jasensiopalao/thermal_camera/schematics/thermal_camera_version_1_0.gif

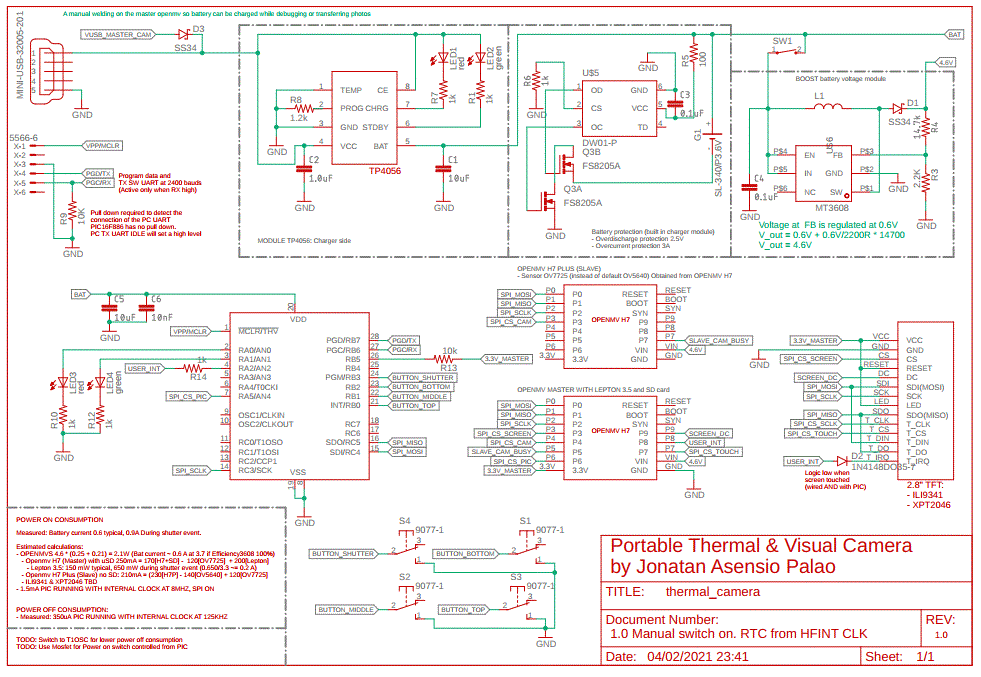
schematics/thermal_camera_version_1_0.gif
