jasensiopalao/thermal_camera/src/openmv_thermal/startup.bmp

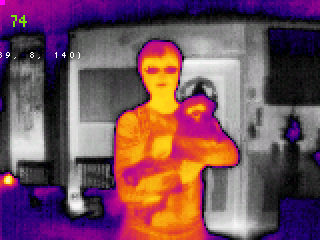
src/openmv_thermal/startup.bmp
