jasensiopalao/thermal_camera/schematics/thermal_camera_1_1.pdf

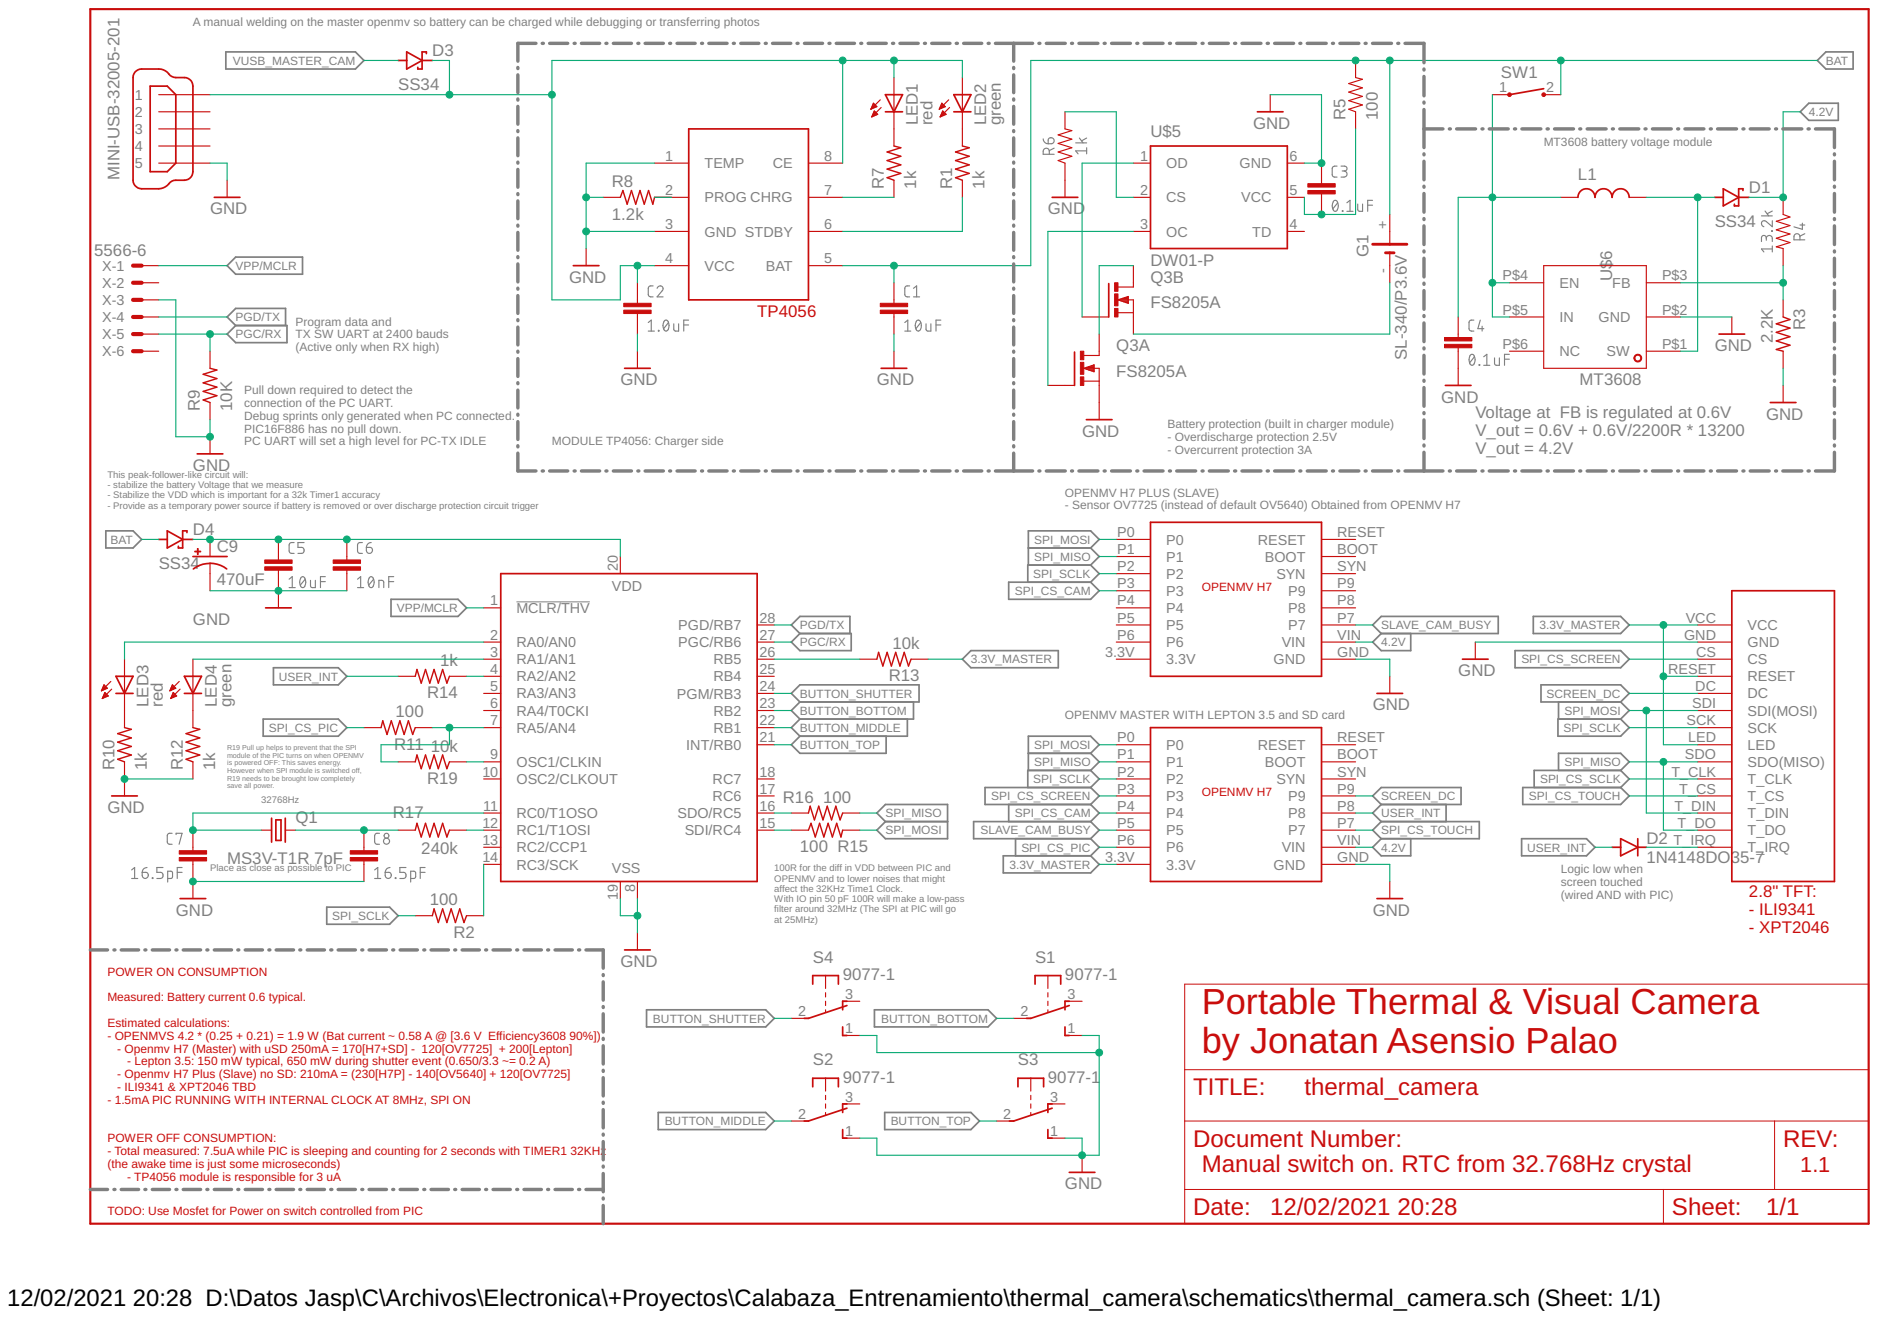
[picture p23: page 1]

A manual welding on the master openmv so battery can be charged while debugging or transferring photos

P$1 GND

Program data and TX SW UART at 2400 bauds

(Active only when RX high)

Pull down required to detect the
connection of the PC UART. Debug sprints only generated when PC connected. PIC16F886 has no pull down. PC UART will set a high level for PC-TX IDLE

This peak-follower-like circuit will: - stabilize the battery Voltage that we measure

OPENMV H7 PLUS (SLAVE)
- Sensor OV7725 (instead of default OV5640) Obtained from OPENMV H7

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

OPENMV MASTER WITH LEPTON 3.5 and SD card

R19 Pull up helps to prevent that the SPI module of the PIC turns on when OPENMV

is powered OFF: This saves energy. However when SPI module is switched off, R19 needs to be brought low completely

Place as close as possible to PIC

(wired AND with PIC) 100R for the diff in VDD between PIC and OPENMV and to lower noises that might affect the 32KHz Time1 Clock. With IO pin 50 pF 100R will make a low-pass

filter around 32MHz (The SPI at PIC will go
at 25MHz)

POWER ON CONSUMPTION Measured: Battery current 0.6 typical. Estimated calculations: - OPENMVS 4.2 * (0.25 + 0.21) = 1.9 W (Bat current ~ 0.58 A @ [3.6 V Efficiency3608 90%])

Portable Thermal & Visual Camera
by Jonatan Asensio Palao

- Openmv H7 (Master) with uSD 250mA = 170[H7+SD] - 120[OV7725] + 200[Lepton] - Lepton 3.5: 150 mW typical, 650 mW during shutter event (0.650/3.3 ~= 0.2 A)

- Openmv H7 Plus (Slave) no SD: 210mA = (230[H7P] - 140[OV5640] + 120[OV7725] - ILI9341 & XPT2046 TBD

- 1.5mA PIC RUNNING WITH INTERNAL CLOCK AT 8MHz, SPI ON

POWER OFF CONSUMPTION: - Total measured: 7.5uA while PIC is sleeping and counting for 2 seconds with TIMER1 32KHz

Document Number: Manual switch on. RTC from 32.768Hz crystal | REV: 1.1

(the awake time is just some microseconds)
- TP4056 module is responsible for 3 uA

TODO: Use Mosfet for Power on switch controlled from PIC

Date: 12/02/2021 20:28 | Sheet: 1/1

12/02/2021 20:28 D:\Datos Jasp\C\Archivos\Electronica\+Proyectos\Calabaza_Entrenamiento\thermal_camera\schematics\thermal_camera.sch (Sheet: 1/1)
