jasensiopalao/thermal_camera/schematics/thermal_camera_version_1_0.pdf

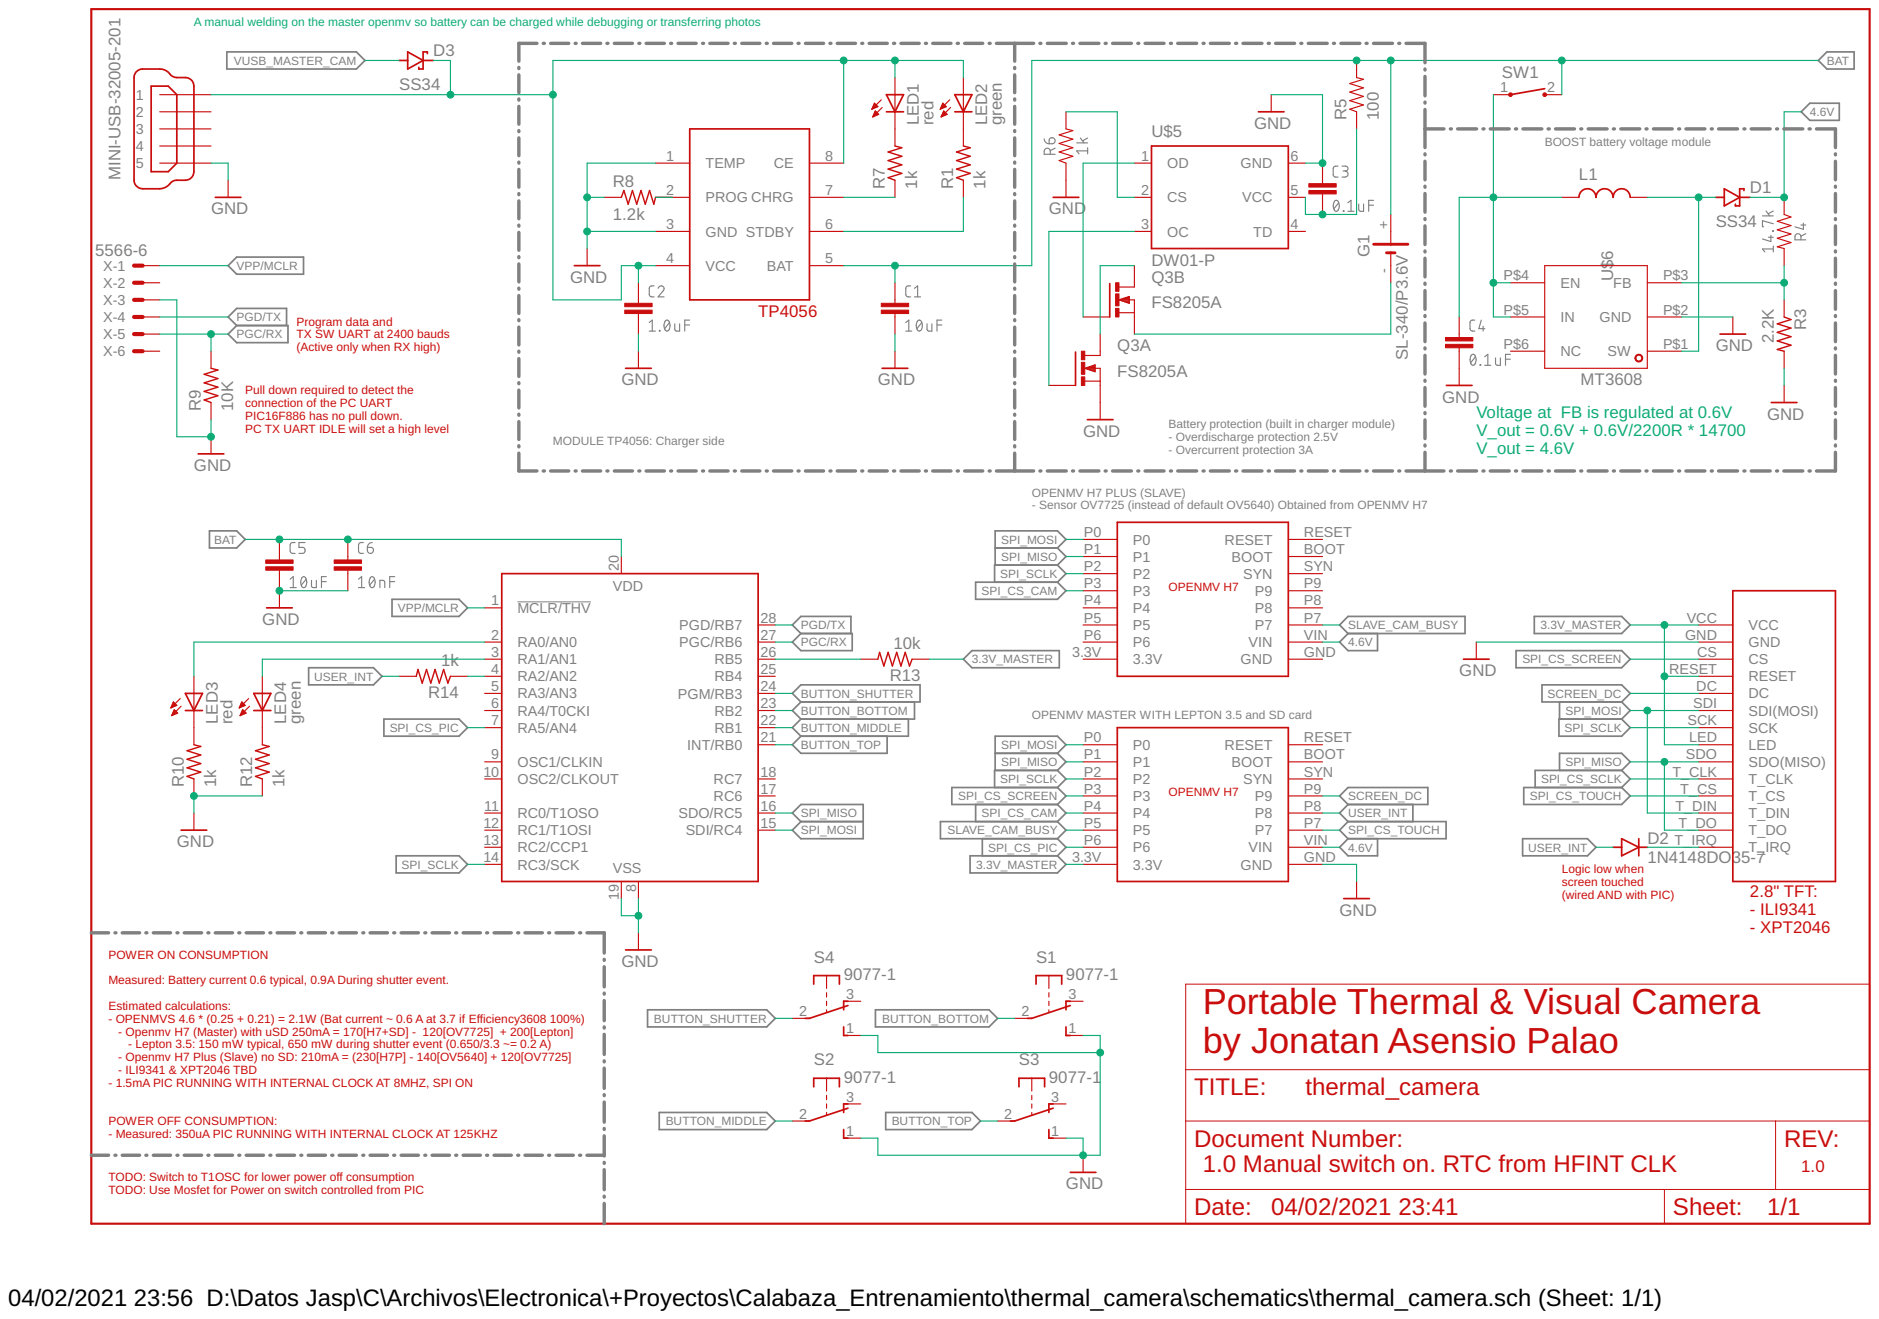
[picture p24: page 1]
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

BOOST battery voltage module

P$1 GND

Program data and TX SW UART at 2400 bauds

(Active only when RX high)

Pull down required to detect the
connection of the PC UART PIC16F886 has no pull down. PC TX UART IDLE will set a high level

OPENMV H7 PLUS (SLAVE)
- Sensor OV7725 (instead of default OV5640) Obtained from OPENMV H7

OPENMV MASTER WITH LEPTON 3.5 and SD card

Logic low when
screen touched
(wired AND with PIC)

POWER ON CONSUMPTION Measured: Battery current 0.6 typical, 0.9A During shutter event. Estimated calculations: - OPENMVS 4.6 * (0.25 + 0.21) = 2.1W (Bat current ~ 0.6 A at 3.7 if Efficiency3608 100%)

Portable Thermal & Visual Camera
by Jonatan Asensio Palao

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

- Openmv H7 Plus (Slave) no SD: 210mA = (230[H7P] - 140[OV5640] + 120[OV7725] - ILI9341 & XPT2046 TBD

- 1.5mA PIC RUNNING WITH INTERNAL CLOCK AT 8MHZ, SPI ON

POWER OFF CONSUMPTION: - Measured: 350uA PIC RUNNING WITH INTERNAL CLOCK AT 125KHZ

Document Number: 1.0 Manual switch on. RTC from HFINT CLK | REV: 1.0

TODO: Switch to T1OSC for lower power off consumption TODO: Use Mosfet for Power on switch controlled from PIC

Date: 04/02/2021 23:41 | Sheet: 1/1

04/02/2021 23:56 D:\Datos Jasp\C\Archivos\Electronica\+Proyectos\Calabaza_Entrenamiento\thermal_camera\schematics\thermal_camera.sch (Sheet: 1/1)
