jasensiopalao/thermal_camera/schematics/thermal_camera.sch

## EAGLE design schematics/thermal_camera.sch (2021-02-14)

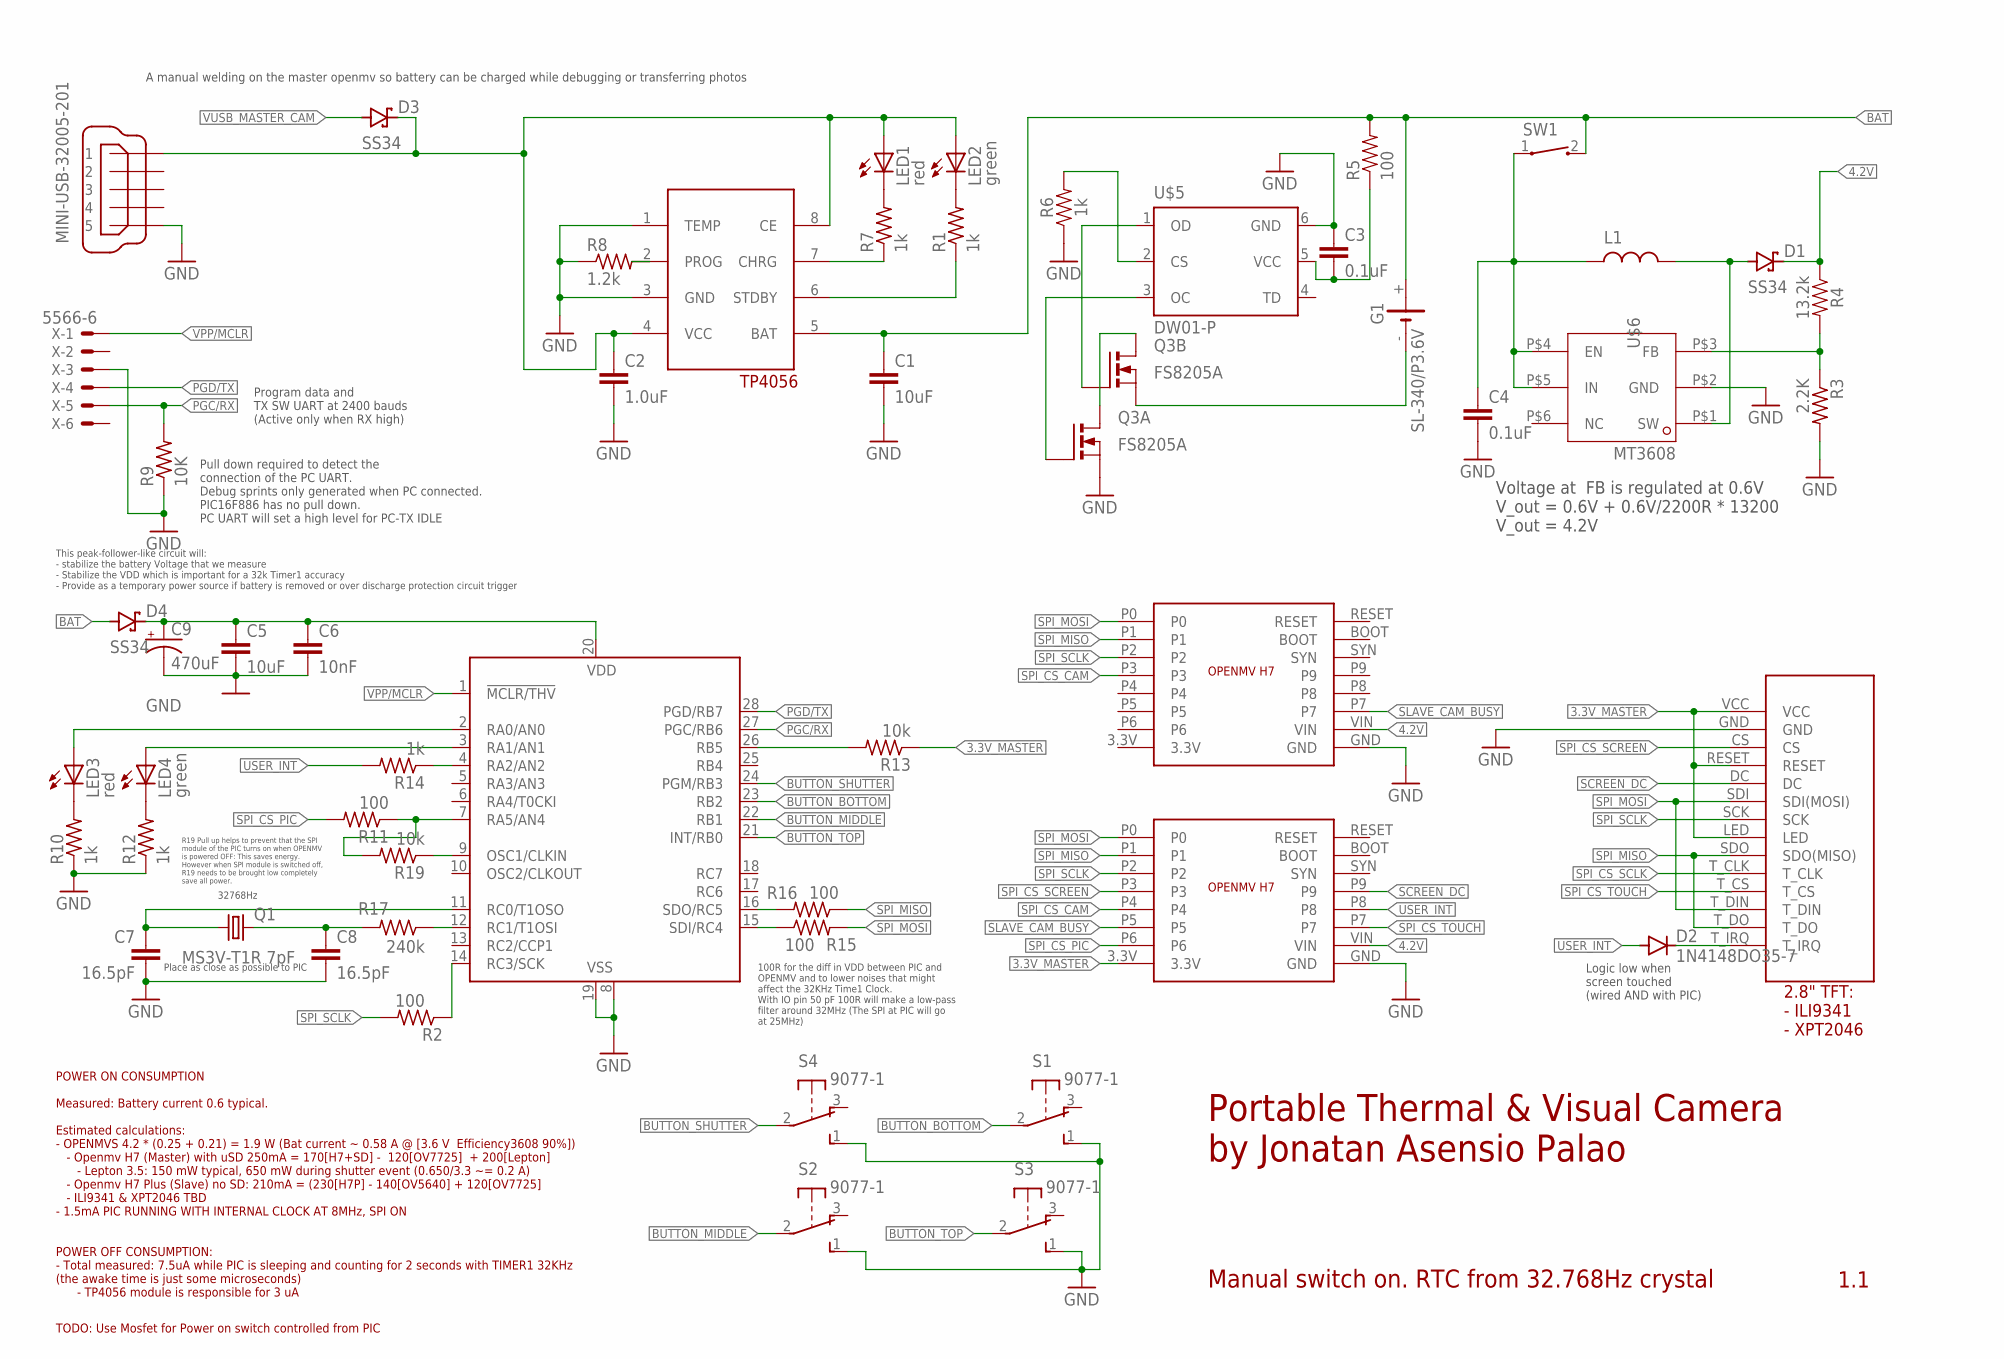
[picture p25: schematic thermal_camera.sch]

Parts:
C1, C5: 10uF; 1206
C2: 1.0uF; 0603
C3, C4: 0.1uF; 0603
C6: 10nF; 1206
C7, C8: 16.5pF; 1206
C9: 470uF; 153CLV-0505
D1, D3, D4: SS34; E2LINE
D2: 1N4148DO35-7; DO35-7
G1: SL-340/P3.6V
IC1: PIC16F876SO; SO28W
LED1, LED3: red; CHIP-LED0805
LED2, LED4: green; CHIP-LED0805
Q1: MS3V-T1R 7pF; FC-12M
Q3: FS8205A; DE_X
R1, R7, R10, R12, R14: 1k; 0204/7
R2, R11, R15, R16: 100; 0204/7
R3: 2.2K; 0204/7
R4: 13.2k; 0603
R5: 100; 0603-RES
R6: 1k; 0603
R8: 1.2k; 0204/7
R9: 10K; 0204/7
R13, R19: 10k; 0204/7
R17: 240k; 0204/7
S1, S2, S3, S4: 9077-1
SW1: CT10-XXXX-A2
U$1, U$2: OPENMV_H7; OPENMV_FOOTPRINT
U$3: TP4056SO8; SSOP08
U$4: SCREEN_2_8_INCH; SCREEN_2_8
U$5: DW01-P; SOT23-6L
U$6: MT3608SOT23-6; SOT23-6
X: 5566-6
X1: MINI-USB-32005-201; 32005-201

Connections:
3.3V_MASTER: R13.1, U$1.3.3V, U$4.LED, U$4.RESET, U$4.VCC
4.2V: D1.1 (K), R4.1, U$1.VIN, U$2.VIN
BAT: C1.1, C5.1, C6.1, C9.+, D4.1 (K), D4.2 (A), G1.+, IC1.20 (VDD), R5.2, SW1.2, U$3.5 (BAT)
BUTTON_BOTTOM: IC1.23 (RB2), S1.2
BUTTON_MIDDLE: IC1.22 (RB1), S2.2
BUTTON_SHUTTER: IC1.24 (PGM/RB3), S4.2
BUTTON_TOP: IC1.21 (INT/RB0), S3.2
CHRG: R7.1, U$3.7 (CHRG)
GND: C1.2, C2.2, C3.1, C4.2, C5.2, C6.2, C7.2, C8.2, C9.-, IC1.8 (VSS), IC1.19 (VSS), Q3.SD1 (SG1), R3.2, R6.1, R8.1, R9.1, R10.1, R12.1, S1.1 (S), S2.1 (S), S3.1 (S), S4.1 (S), U$1.GND, U$2.GND, U$3.1 (TEMP), U$3.3 (GND), U$4.GND, U$5.6 (GND), U$6.P$2 (GND), X.3, X1.5
unnamed: R6.2, U$5.2 (CS)
unnamed: Q3.G1 (G), U$5.3 (OC)
unnamed: R8.2, U$3.2 (PROG)
unnamed: C2.1, D3.1 (K), LED1.A, LED2.A, U$3.4 (VCC), U$3.8 (CE), X1.1
unnamed: Q3.D1 (D), Q3.D2 (D)
unnamed: LED2.C, R1.2
unnamed: G1.-, Q3.SD2 (SG1)
unnamed: C4.1, SW1.1, U$6.P$4 (EN), U$6.P$5 (IN)
unnamed: R3.1, R4.2, U$6.P$3 (FB)
unnamed: D1.2 (A), U$6.P$1 (SW)
unnamed: R1.1, U$3.6 (STDBY)
unnamed: IC1.2 (RA0/AN0), LED3.A
unnamed: IC1.4 (RA2/AN2), R14.1
unnamed: IC1.14 (RC3/SCK), R2.1
unnamed: LED3.C, R10.2
unnamed: LED4.C, R12.2
unnamed: IC1.3 (RA1/AN1), LED4.A
unnamed: IC1.7 (RA5/AN4), R11.1, R19.2
unnamed: IC1.26 (RB5), R13.2
unnamed: LED1.C, R7.2
unnamed: IC1.9 (OSC1/CLKIN), R19.1
unnamed: IC1.12 (RC1/T1OSI), R17.1
unnamed: C7.1, IC1.11 (RC0/T1OSO), Q1.1
unnamed: C8.1, Q1.2, R17.2
unnamed: D2.C, U$4.T_IRQ
OD: Q3.G2 (G), U$5.1 (OD)
PGC/RX: IC1.27 (PGC/RB6), R9.2, X.5
PGD/TX: IC1.28 (PGD/RB7), X.4
SCREEN_DC: U$1.P9, U$4.DC
SLAVE_CAM_BUSY: U$1.P5, U$2.P7
SPI_CS_CAM: U$1.P4, U$2.P3
SPI_CS_PIC: R11.2, U$1.P6
SPI_CS_SCLK: U$4.T_CLK
SPI_CS_SCREEN: U$1.P3, U$4.CS
SPI_CS_TOUCH: U$1.P7, U$4.T_CS
SPI_MISO: IC1.16 (SDO/RC5), R15.1, R15.2, U$1.P1, U$2.P1, U$4.SDO (SDO(MISO)), U$4.T_DO
SPI_MOSI: IC1.15 (SDI/RC4), R16.1, R16.2, U$1.P0, U$2.P0, U$4.SDI (SDI(MOSI)), U$4.T_DIN
SPI_SCLK: R2.2, U$1.P2, U$2.P2, U$4.SCK
USER_INT: D2.A, R14.2, U$1.P8
VCC-DW: C3.2, R5.1, U$5.5 (VCC)
VPP/MCLR: IC1.1 (!MCLR/THV), X.1
VUSB_MASTER_CAM: D3.2 (A)

Notes on the sheet:
Portable Thermal & Visual Camera by Jonatan Asensio Palao
Manual switch on. RTC from 32.768Hz crystal
1.1
Voltage at FB is regulated at 0.6V V_out = 0.6V + 0.6V/2200R * 13200 V_out = 4.2V
A manual welding on the master openmv so battery can be charged while debugging or transferring photos
POWER ON CONSUMPTION Measured: Battery current 0.6 typical. Estimated calculations: - OPENMVS 4.2 * (0.25 + 0.21) = 1.9 W (Bat current ~ 0.58 A @ [3.6 V Efficiency3608 90%]) - Openmv H7 (Master) with uSD 250mA = 170[H7+SD] - 120[OV7725] + 200[Lepton] - Lepton 3.5: 150 mW typical, 650 mW during shut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
Pull down required to detect the connection of the PC UART. Debug sprints only generated when PC connected. PIC16F886 has no pull down. PC UART will set a high level for PC-TX IDLE
Program data and TX SW UART at 2400 bauds (Active only when RX high)
Logic low when screen touched (wired AND with PIC)
TODO: Use Mosfet for Power on switch controlled from PIC
100R for the diff in VDD between PIC and OPENMV and to lower noises that might affect the 32KHz Time1 Clock. With IO pin 50 pF 100R will make a low-pass filter around 32MHz (The SPI at PIC will go at 25MHz)
This peak-follower-like circuit will: - stabilize the battery Voltage that we measure - Stabilize the VDD which is important for a 32k Timer1 accuracy - Provide as a temporary power source if battery is removed or over discharge protection circuit trigger
Place as close as possible to PIC
32768Hz
R19 Pull up helps to prevent that the SPI module of the PIC turns on when OPENMV is powered OFF: This saves energy. However when SPI module is switched off, R19 needs to be brought low completely save all power.
