jasensiopalao/thermal_camera/(commit log)

2021-01-04 Thermal camera using 2 Openmv with vision fusion Code for: - Openmv H7 Thermal image as master SPI node - Openmv H7 Plus Visual image as slave SPI node - PIC 16F886 as auxiliar processor - Touch scre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
2021-02-04 Version 1.0 Fixes RTC implemented First version of the schematic finished Documenting
    [thermal_camera.sch]
2021-02-14 PIC RTC switched to a 32kHz crystal Other further power optimizations
    [thermal_camera.sch]
2022-06-15 Fix missing files. Fully in sync with sd
    [auxiliary_controller.py, camera_slave_control.py, menu.py, screen.py]
